Benjamin-C/ExploSnake/Breadboard_prototype/Breadboard_prototype_2.jpg

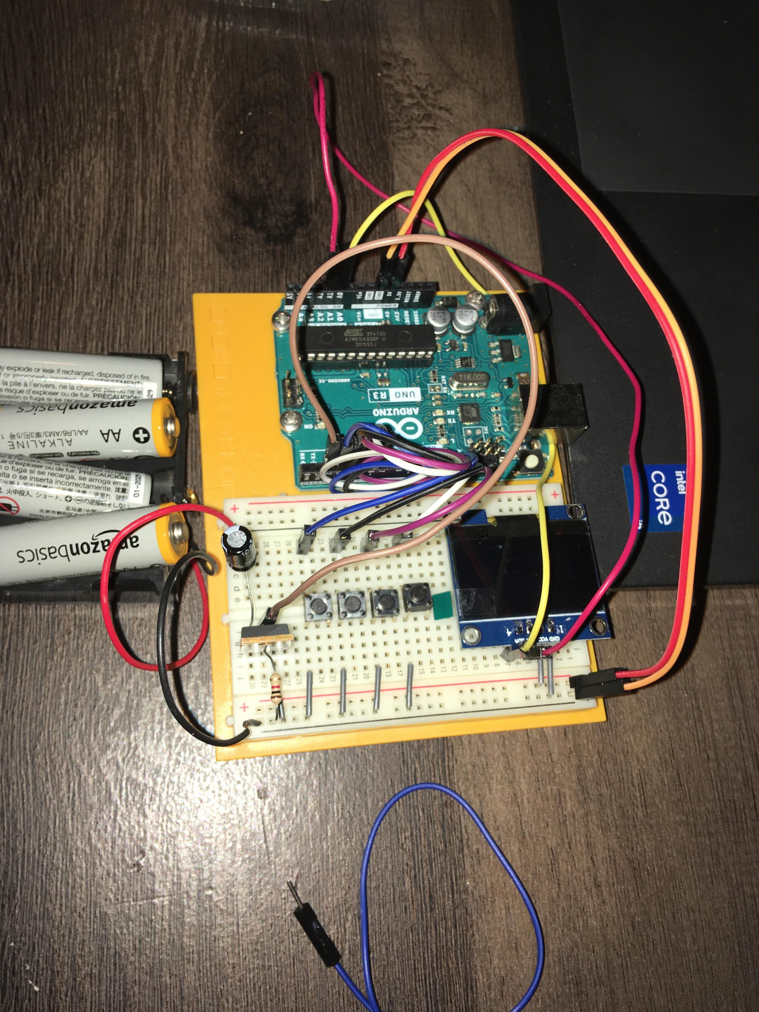
Breadboard_prototype/Breadboard_prototype_2.jpg
