Benjamin-C/ExploSnake/Breadboard_prototype/Breadboard_prototype_1.jpg

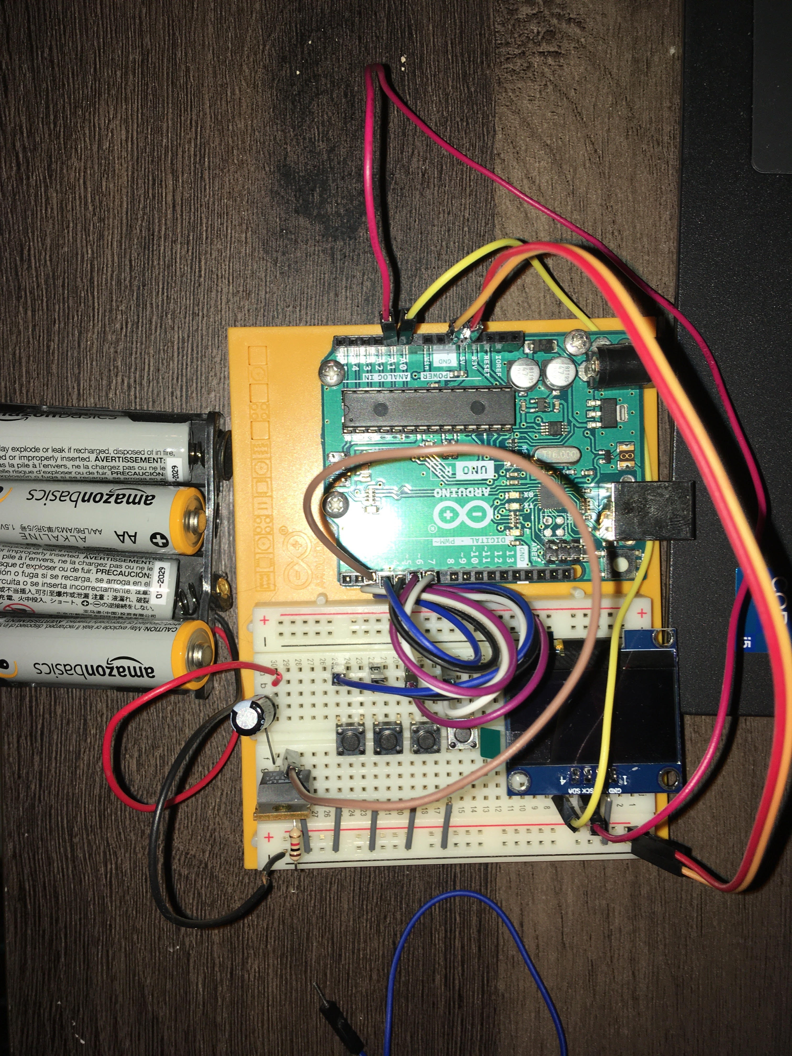
Breadboard_prototype/Breadboard_prototype_1.jpg
