Benjamin-C/ExploSnake/README.md

# ExploSnake
ExploSnake: Handheld Gaming with a Bang!
