Benjamin-C/ExploSnake/Team 2 Function Decomp 411.pdf

# ExploSnake Module

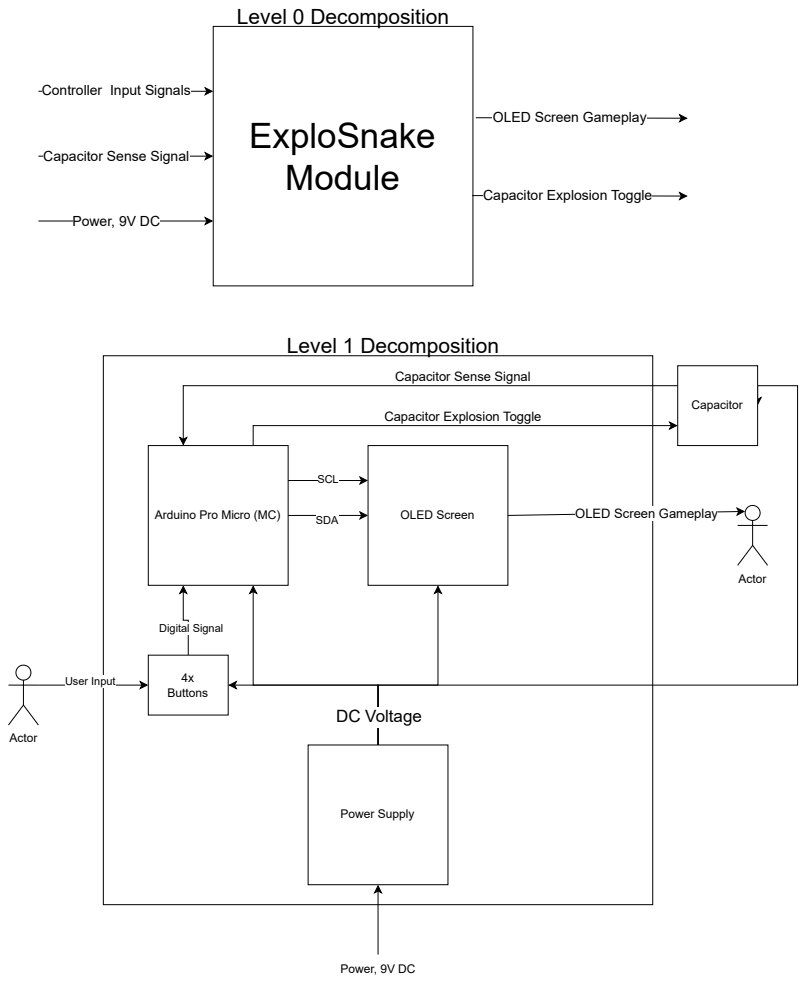
[picture p4: page 1]
Power, 9V DC; Level 0 Decomposition; SDA; Arduino Pro Micro (MC); OLED Screen; SCL; Power Supply; Level 1 Decomposition; Capacitor; Digital Signal; 4x Buttons; DC Voltage; Actor; User Input

Controller Input Signals

OLED Screen Gameplay

Capacitor Sense Signal

Capacitor Explosion Toggle
