Benjamin-C/ExploSnake/es-board/es-board.pdf

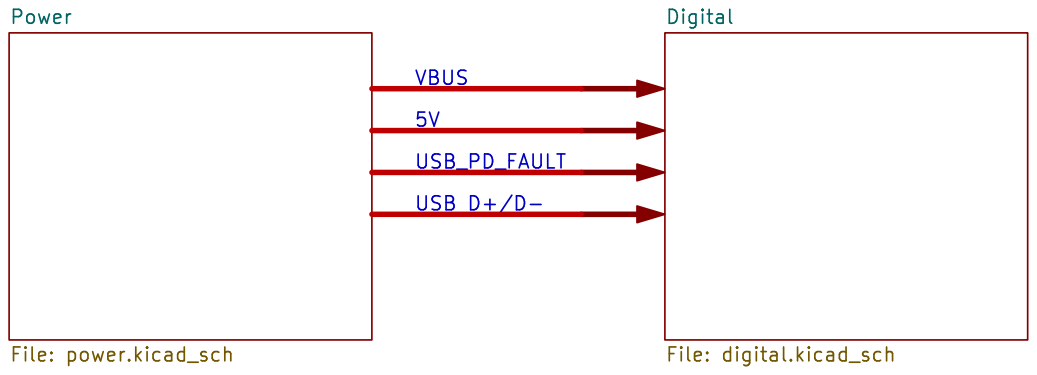
[picture p5: page 1]

Digital File: digital.kicad_sch VBUS

File: es-board.kicad_sch Sheet: / Team 2

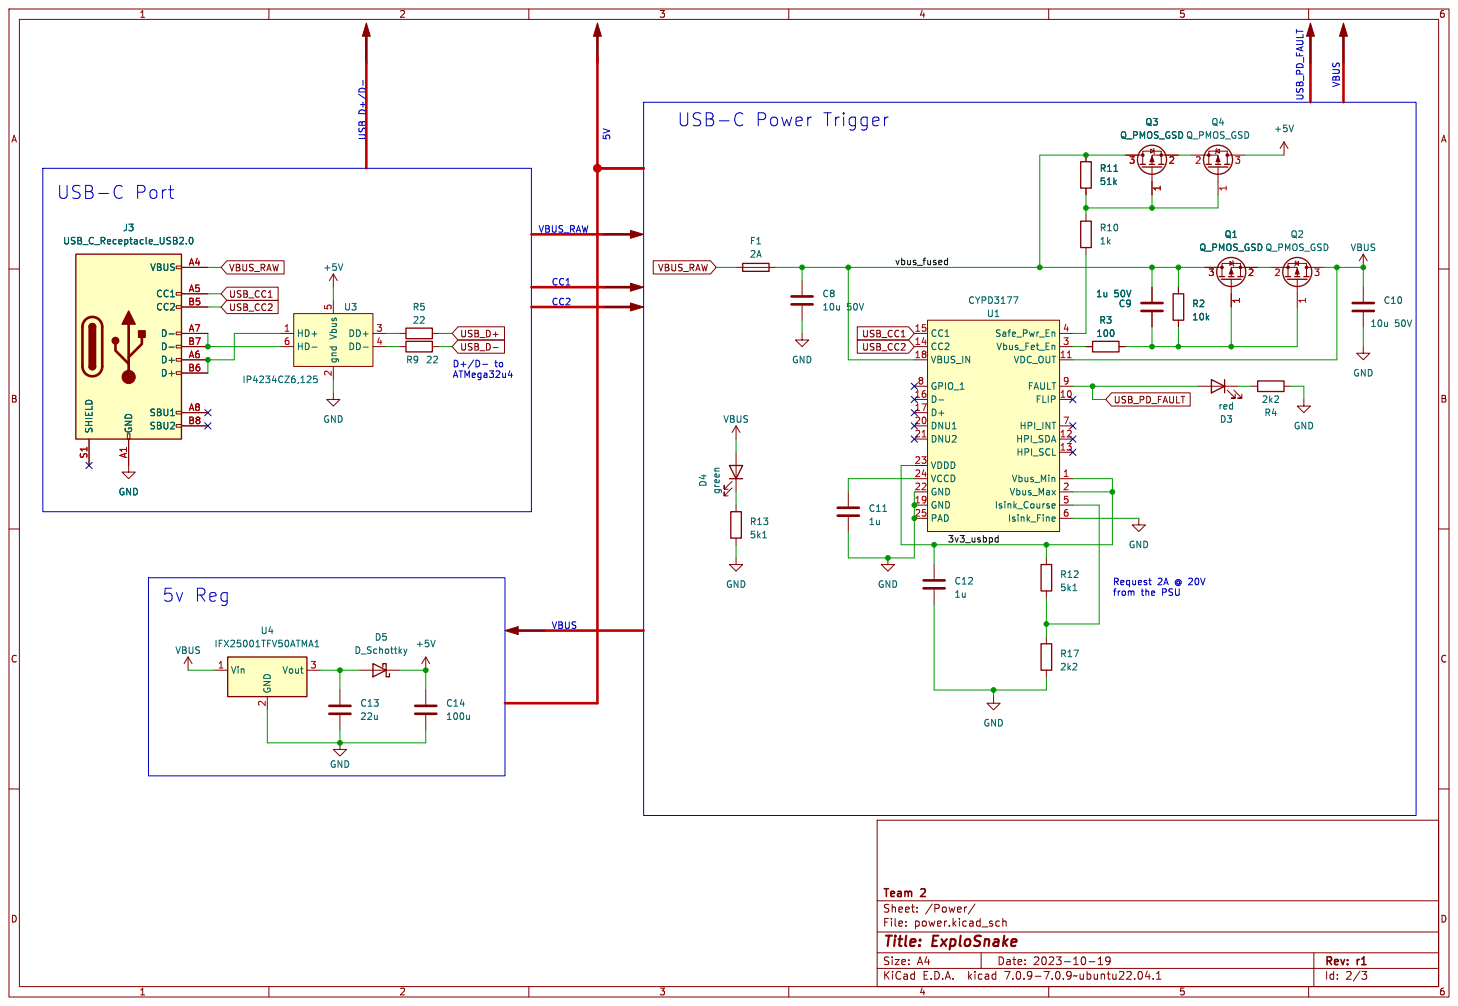
[picture p6: page 2]

from the PSU USB D+/D-

2 DD+ 3 DD- 4 Vbus 5 HD- 6 U3

File: power.kicad_sch Sheet: /Power/ Team 2 R13

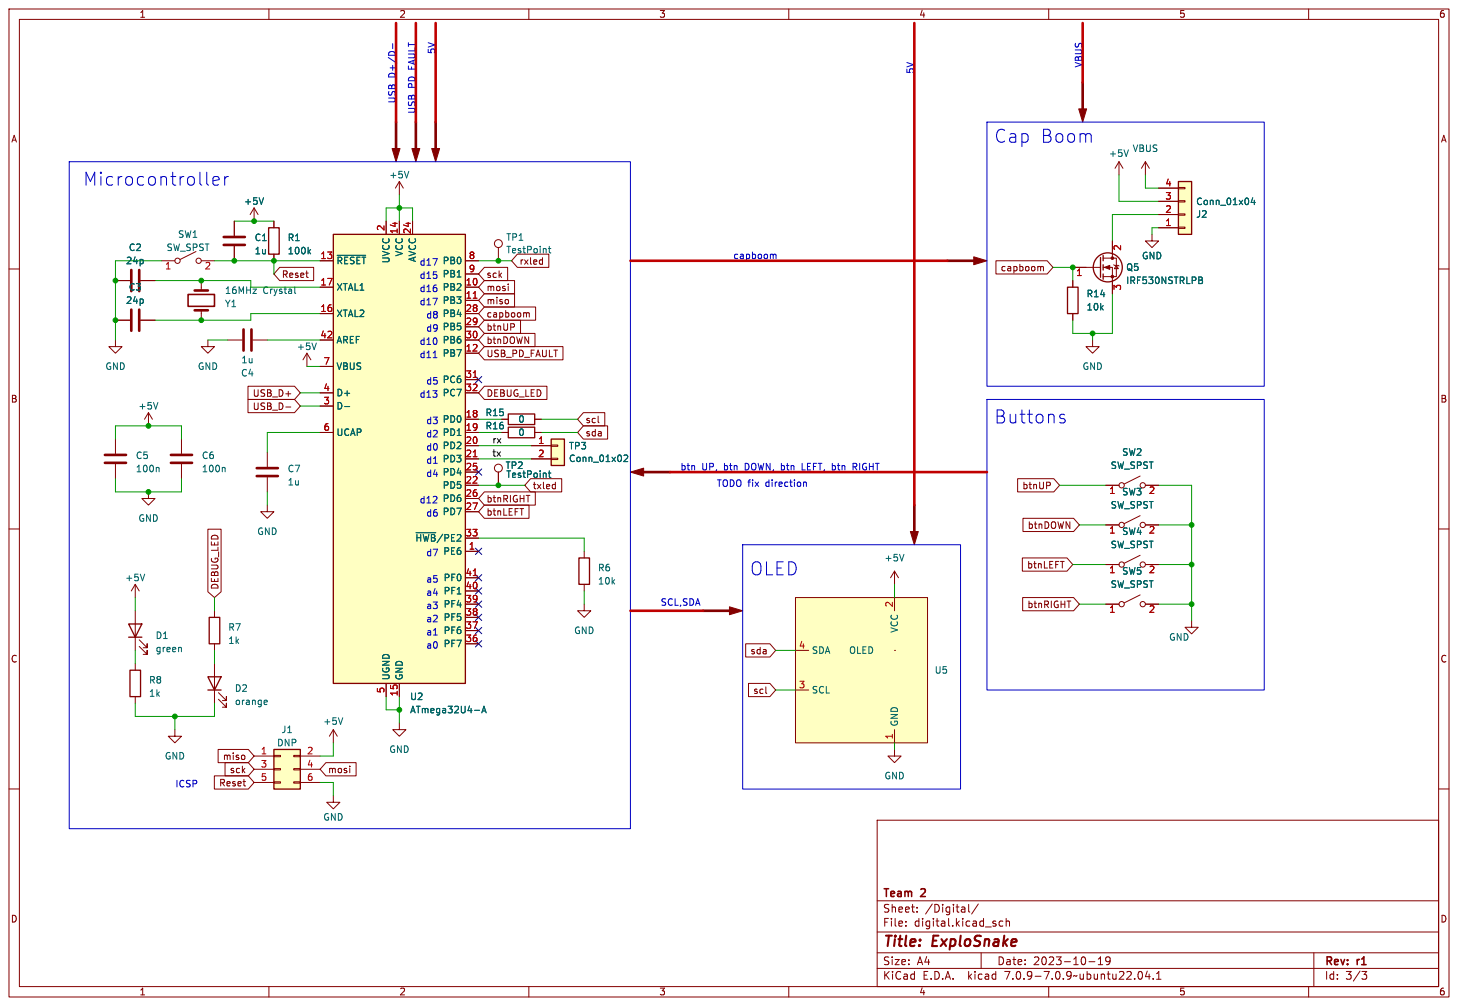
[picture p7: page 3]

btn UP, btn DOWN, btn LEFT, btn RIGHT

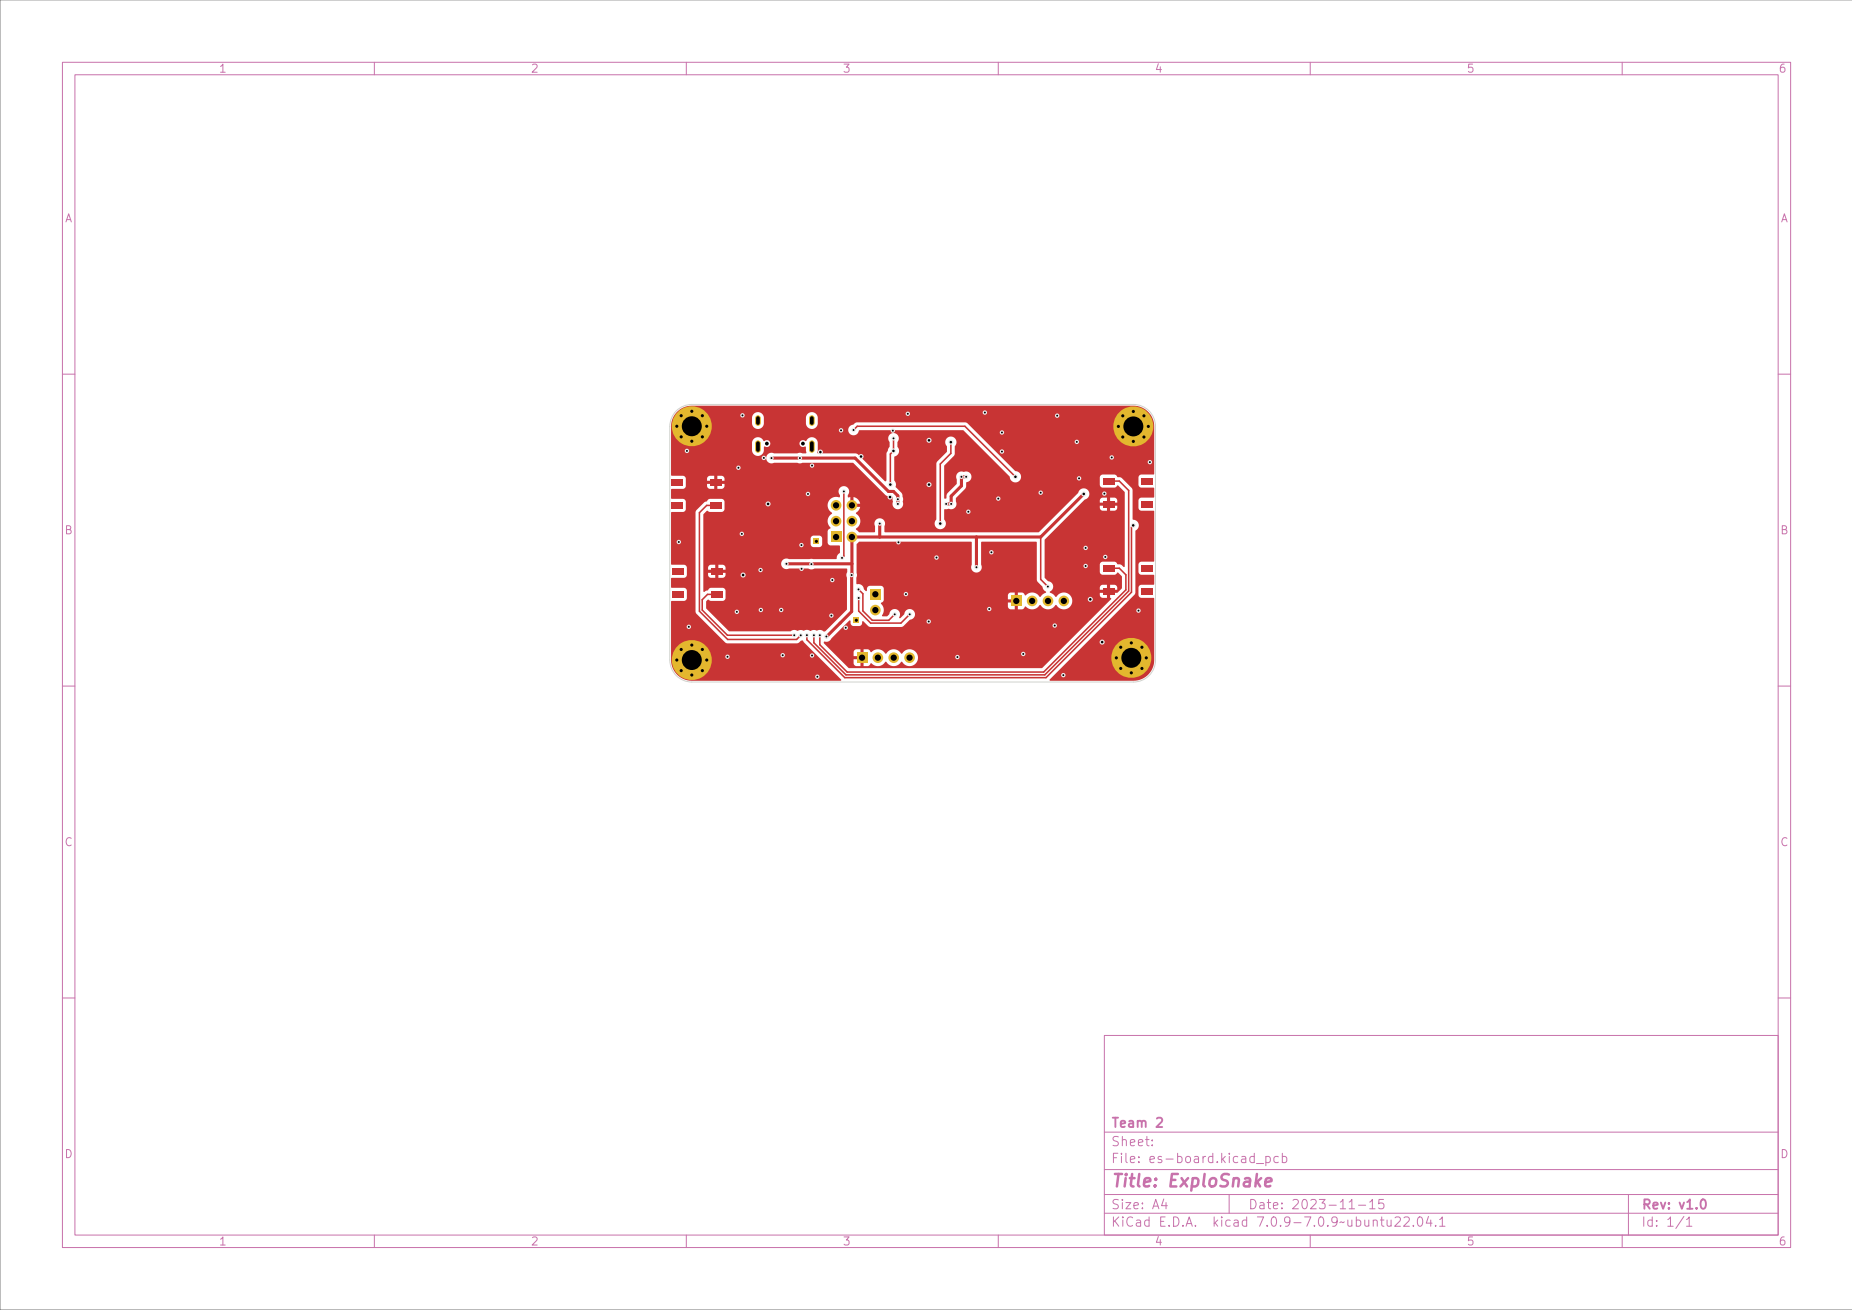
[picture p8: page 4]

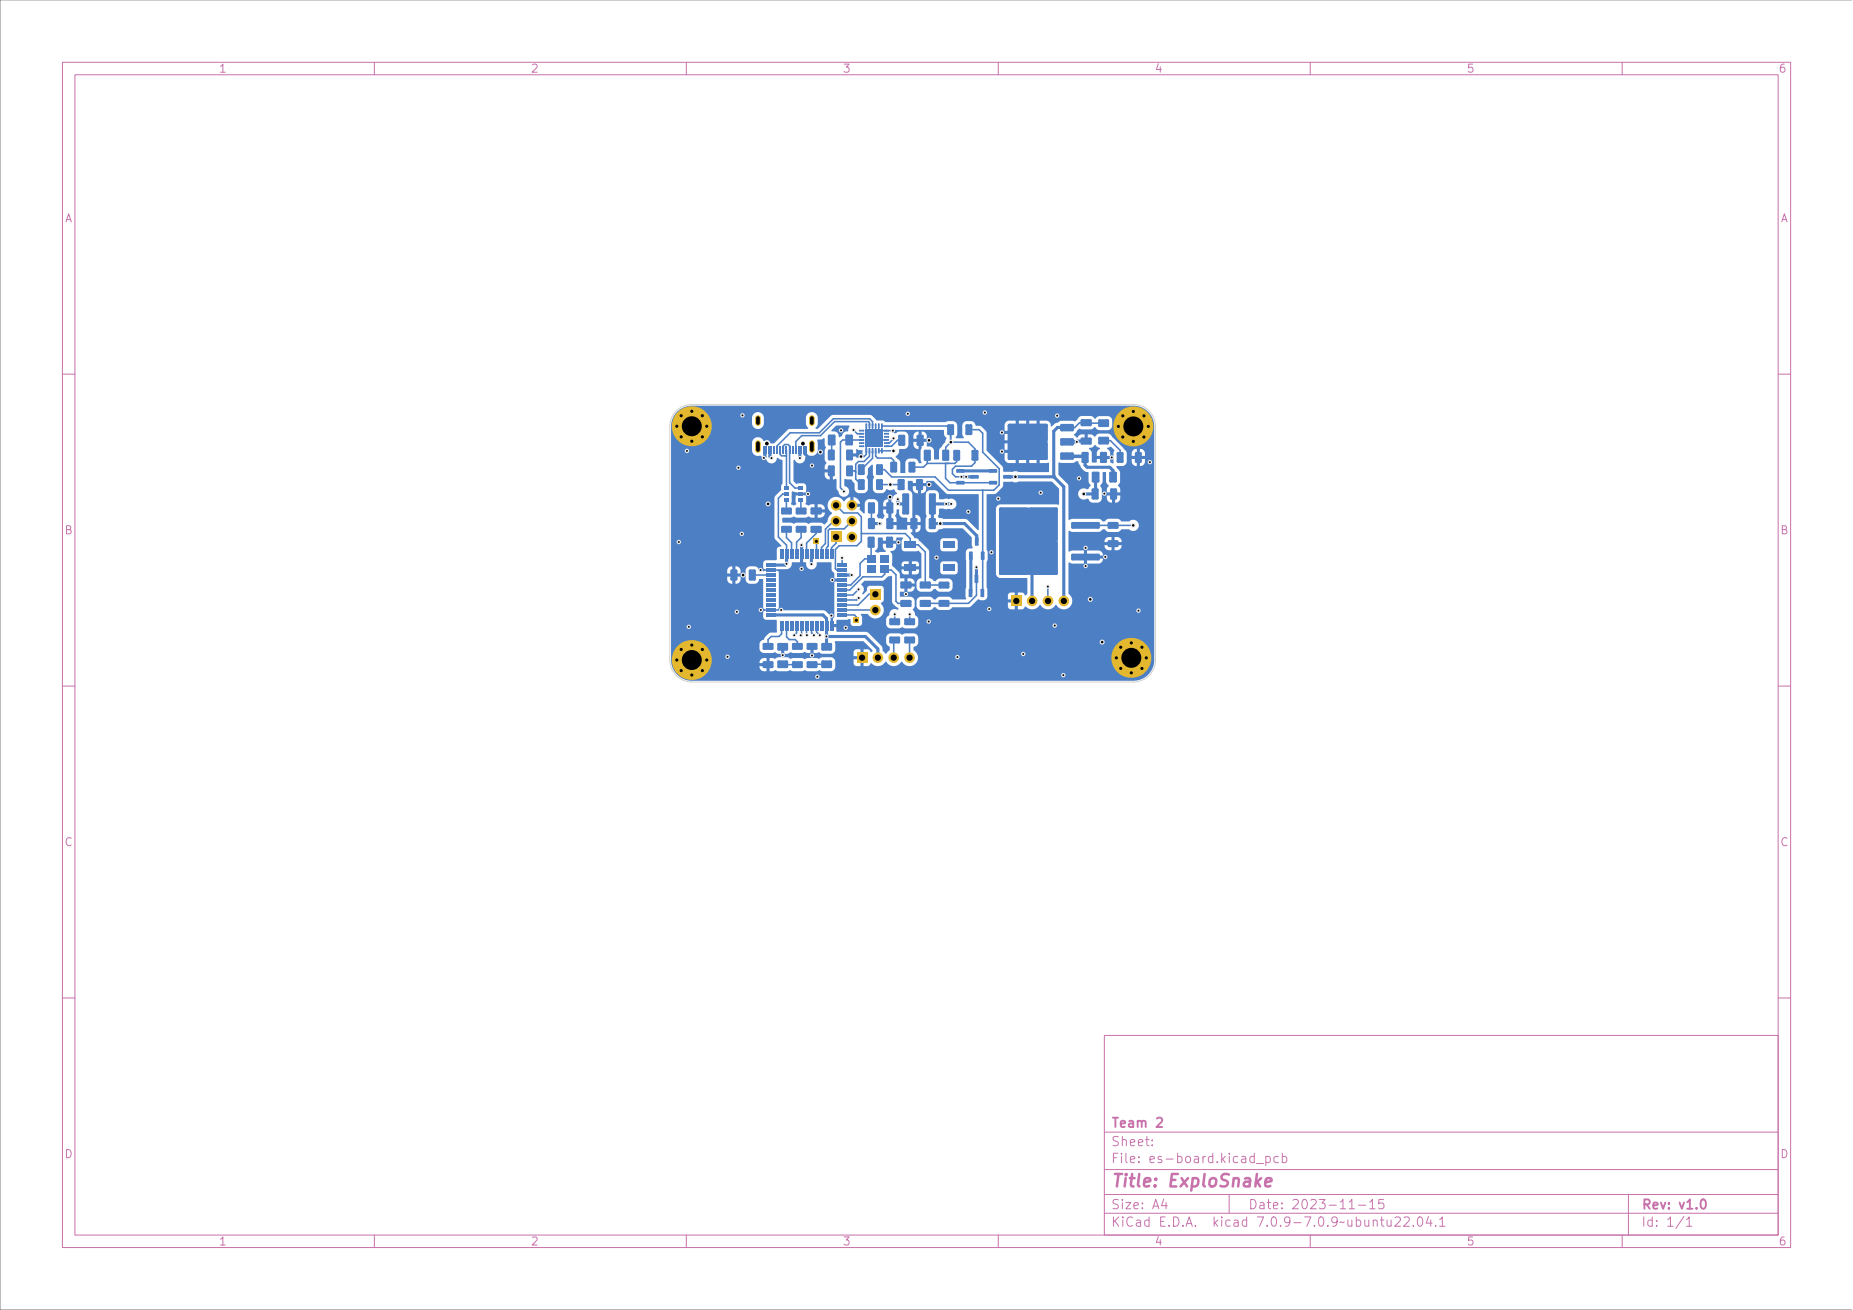
[picture p9: page 5]

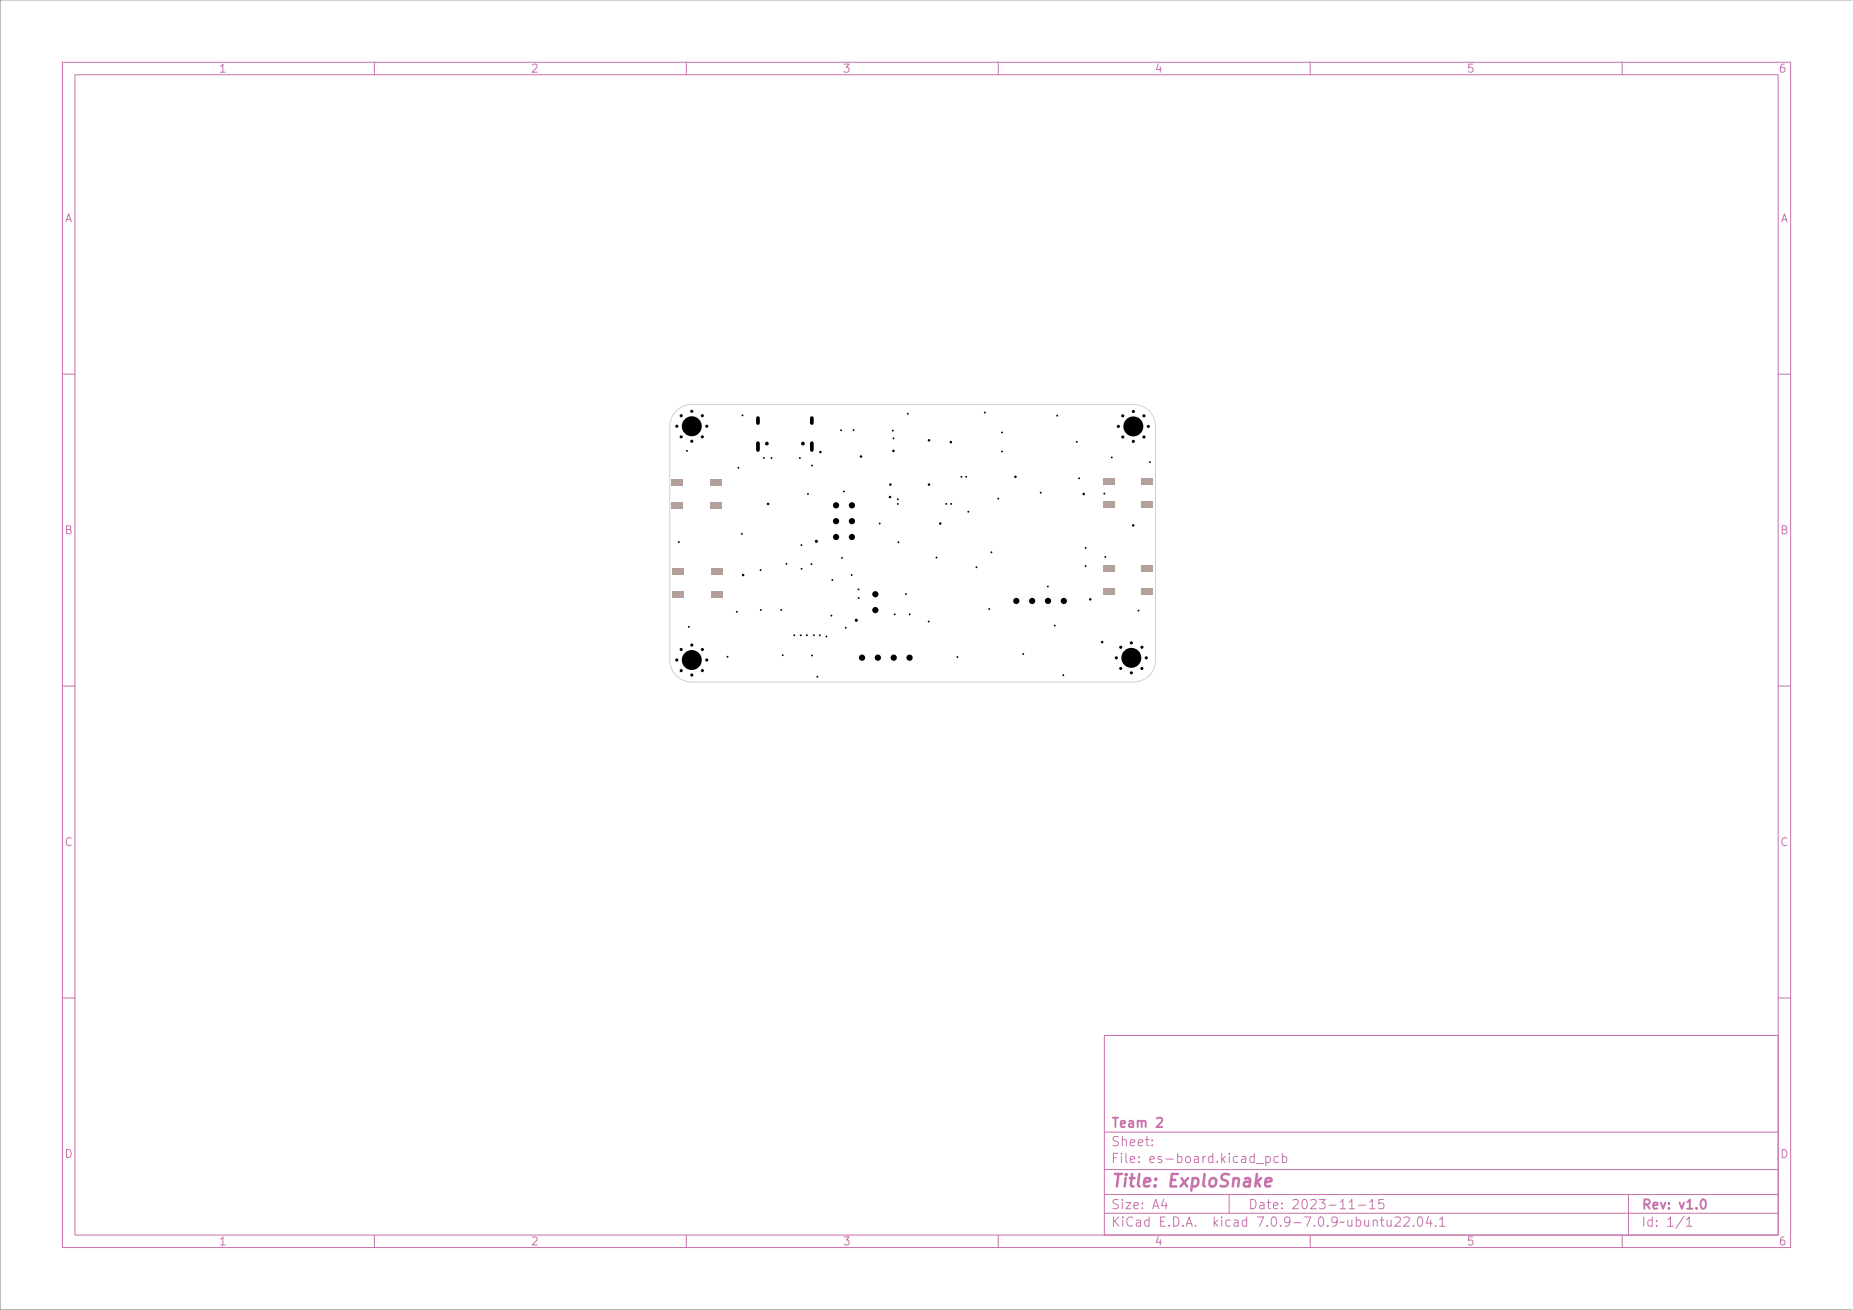
[picture p10: page 6]

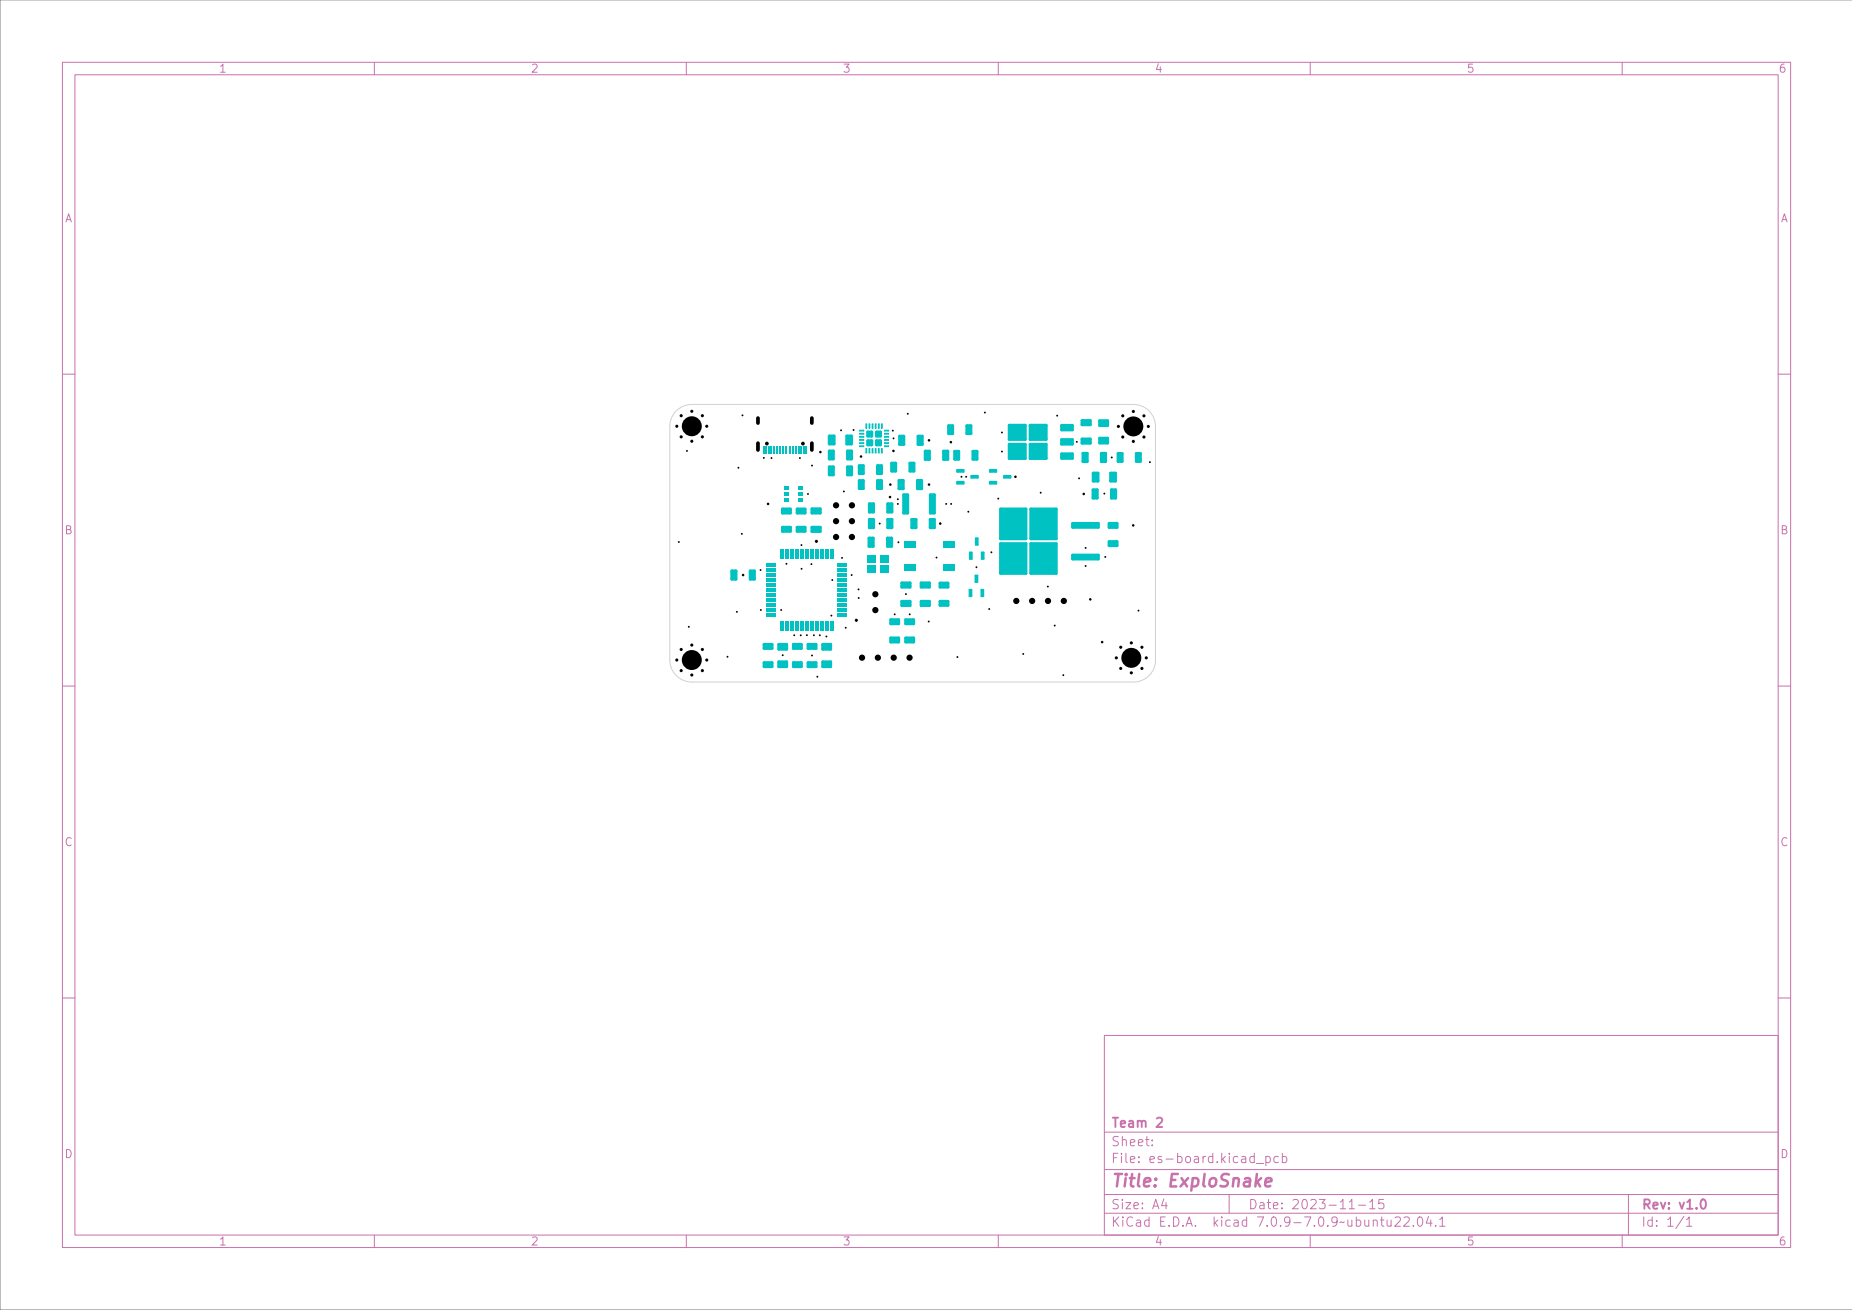
[picture p11: page 7]

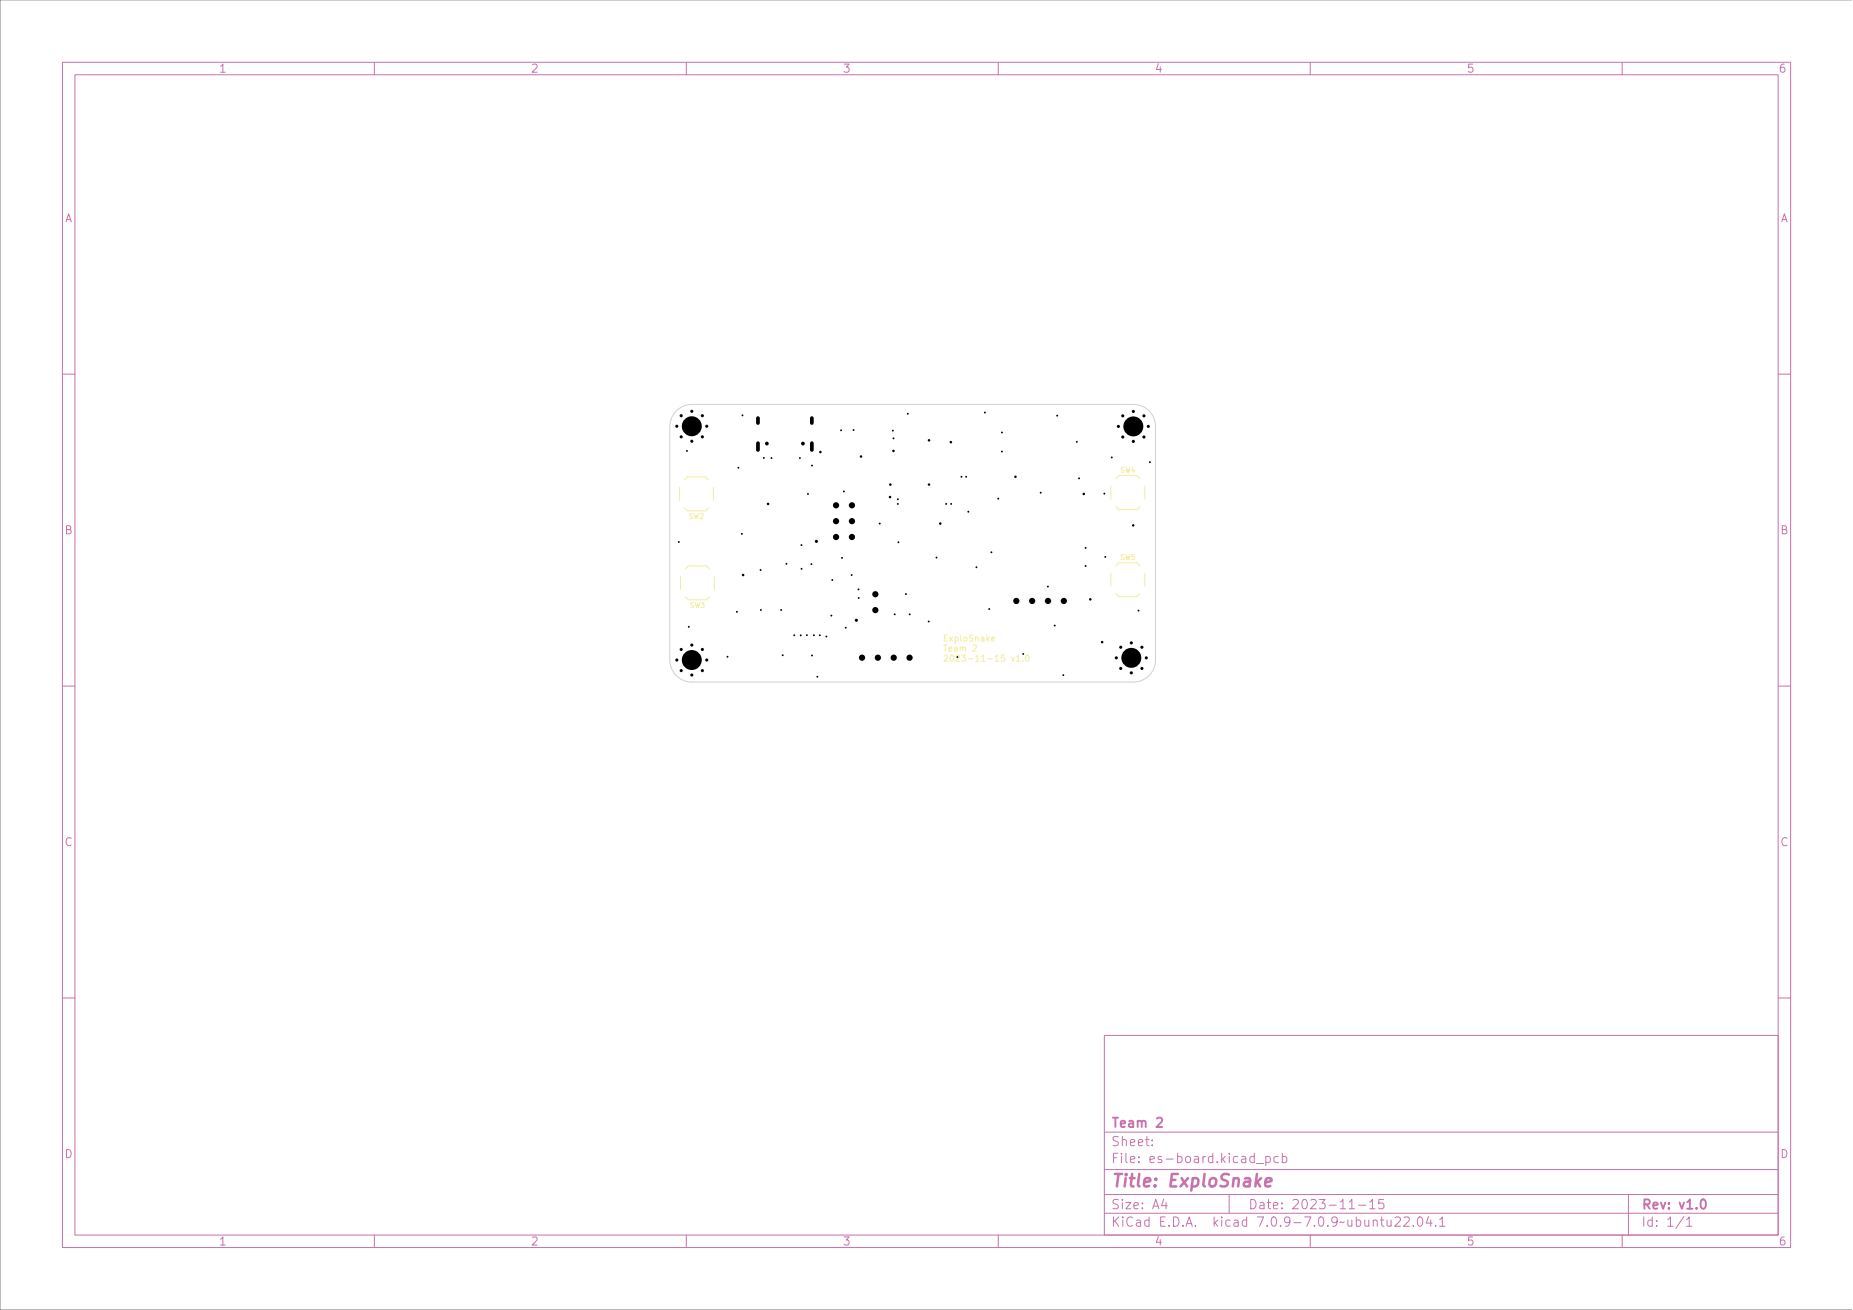
[picture p12: page 8]

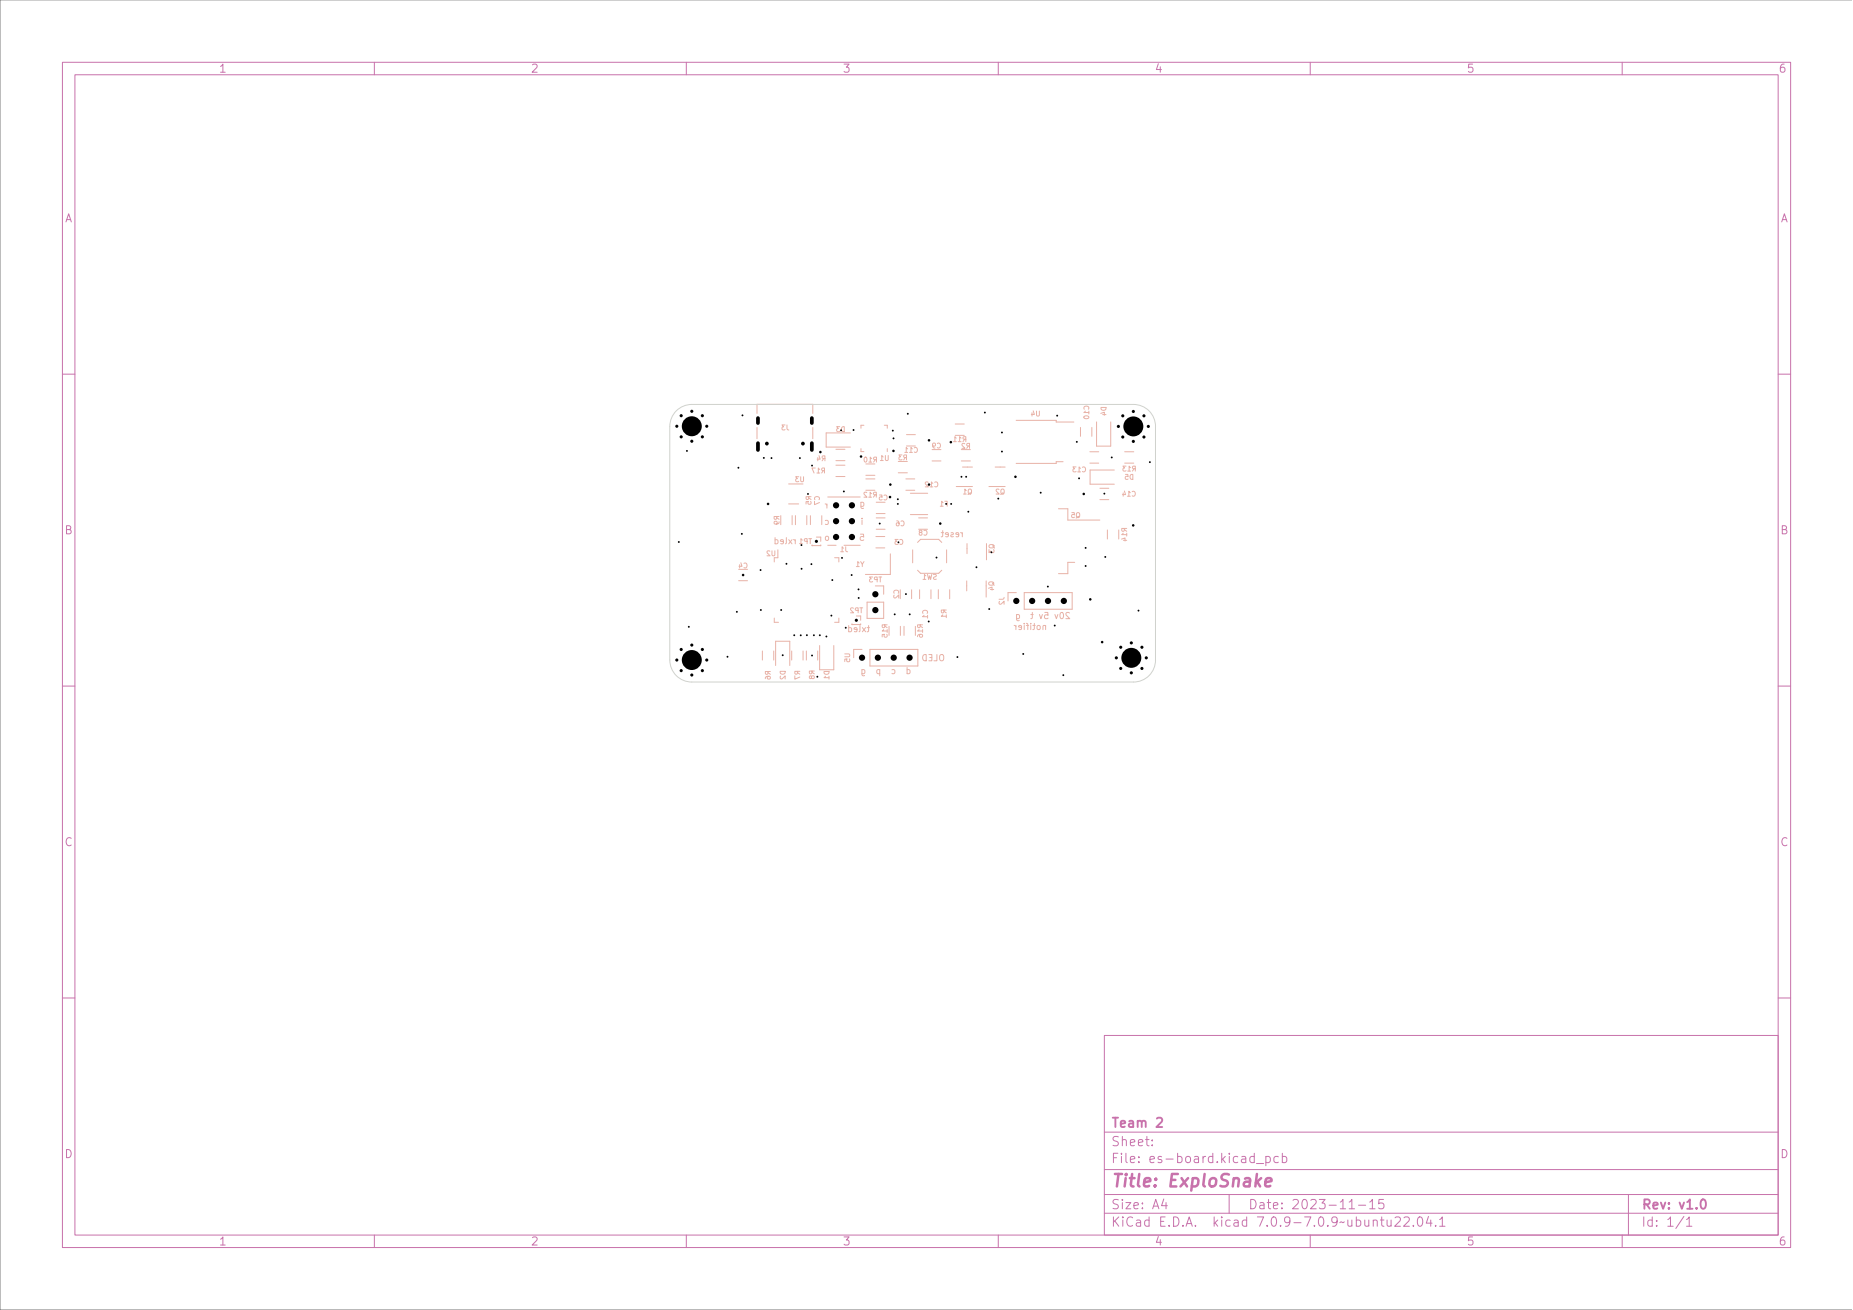
[picture p13: page 9]

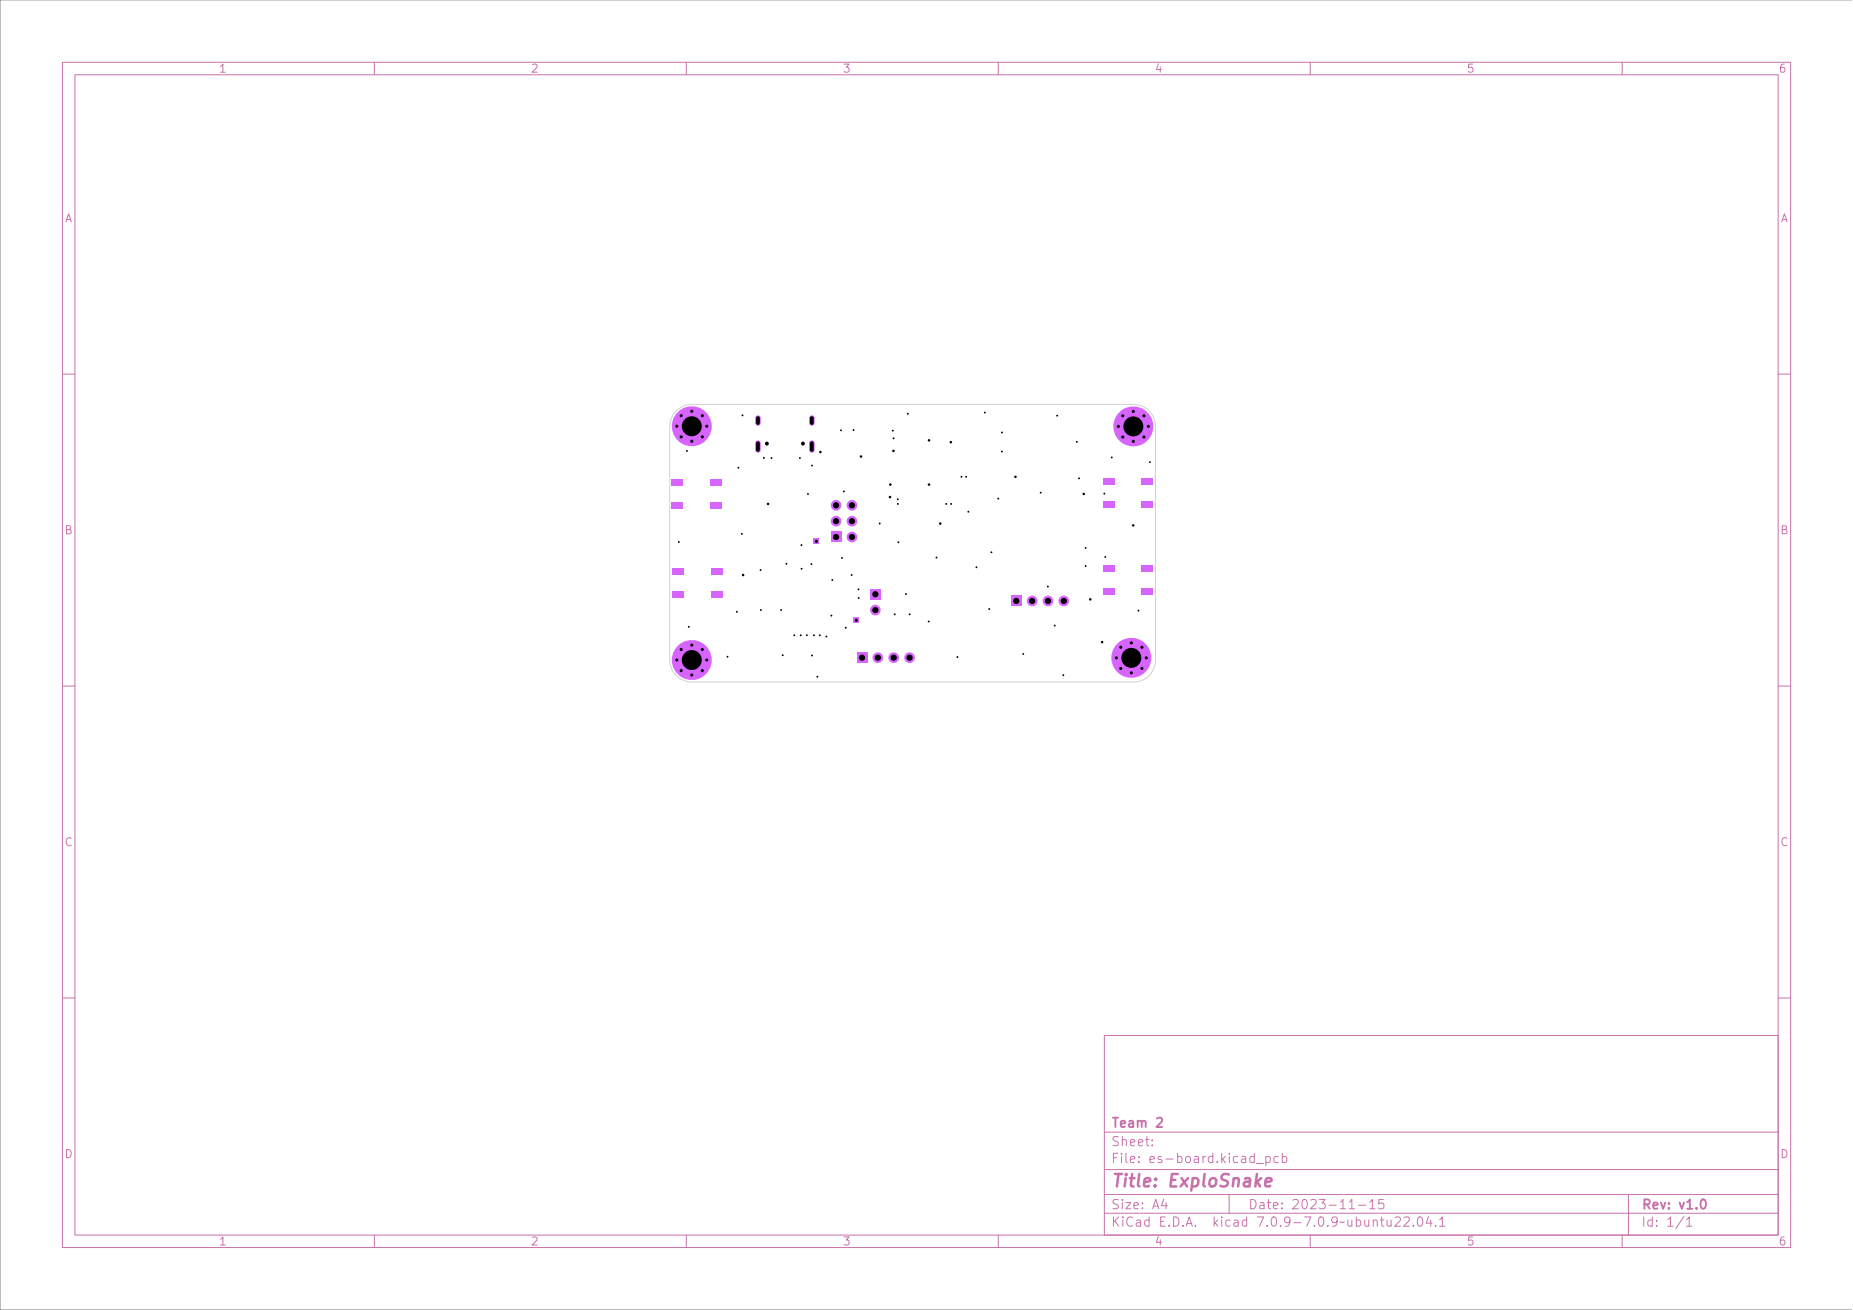
[picture p14: page 10]

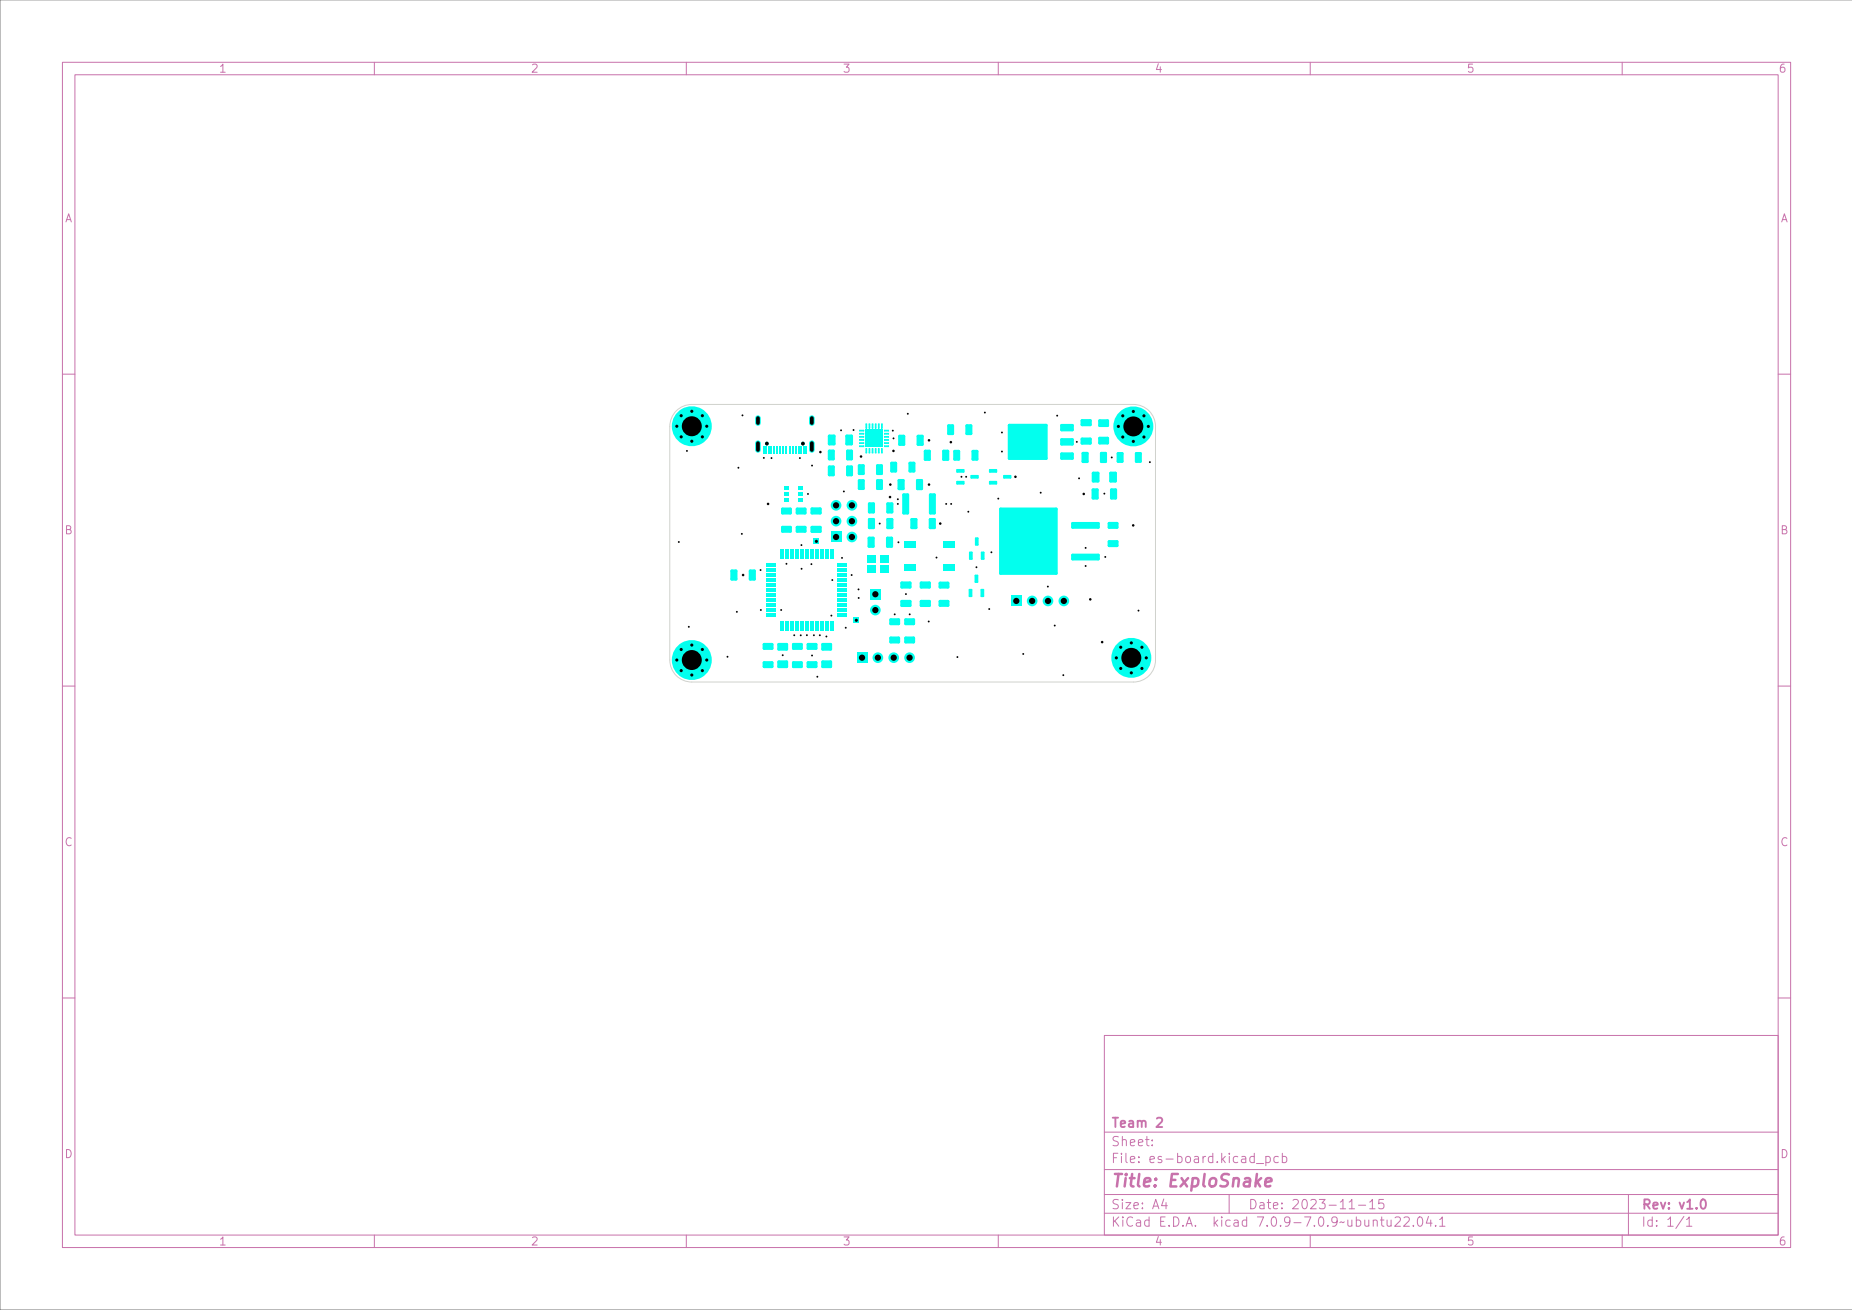
[picture p15: page 11]

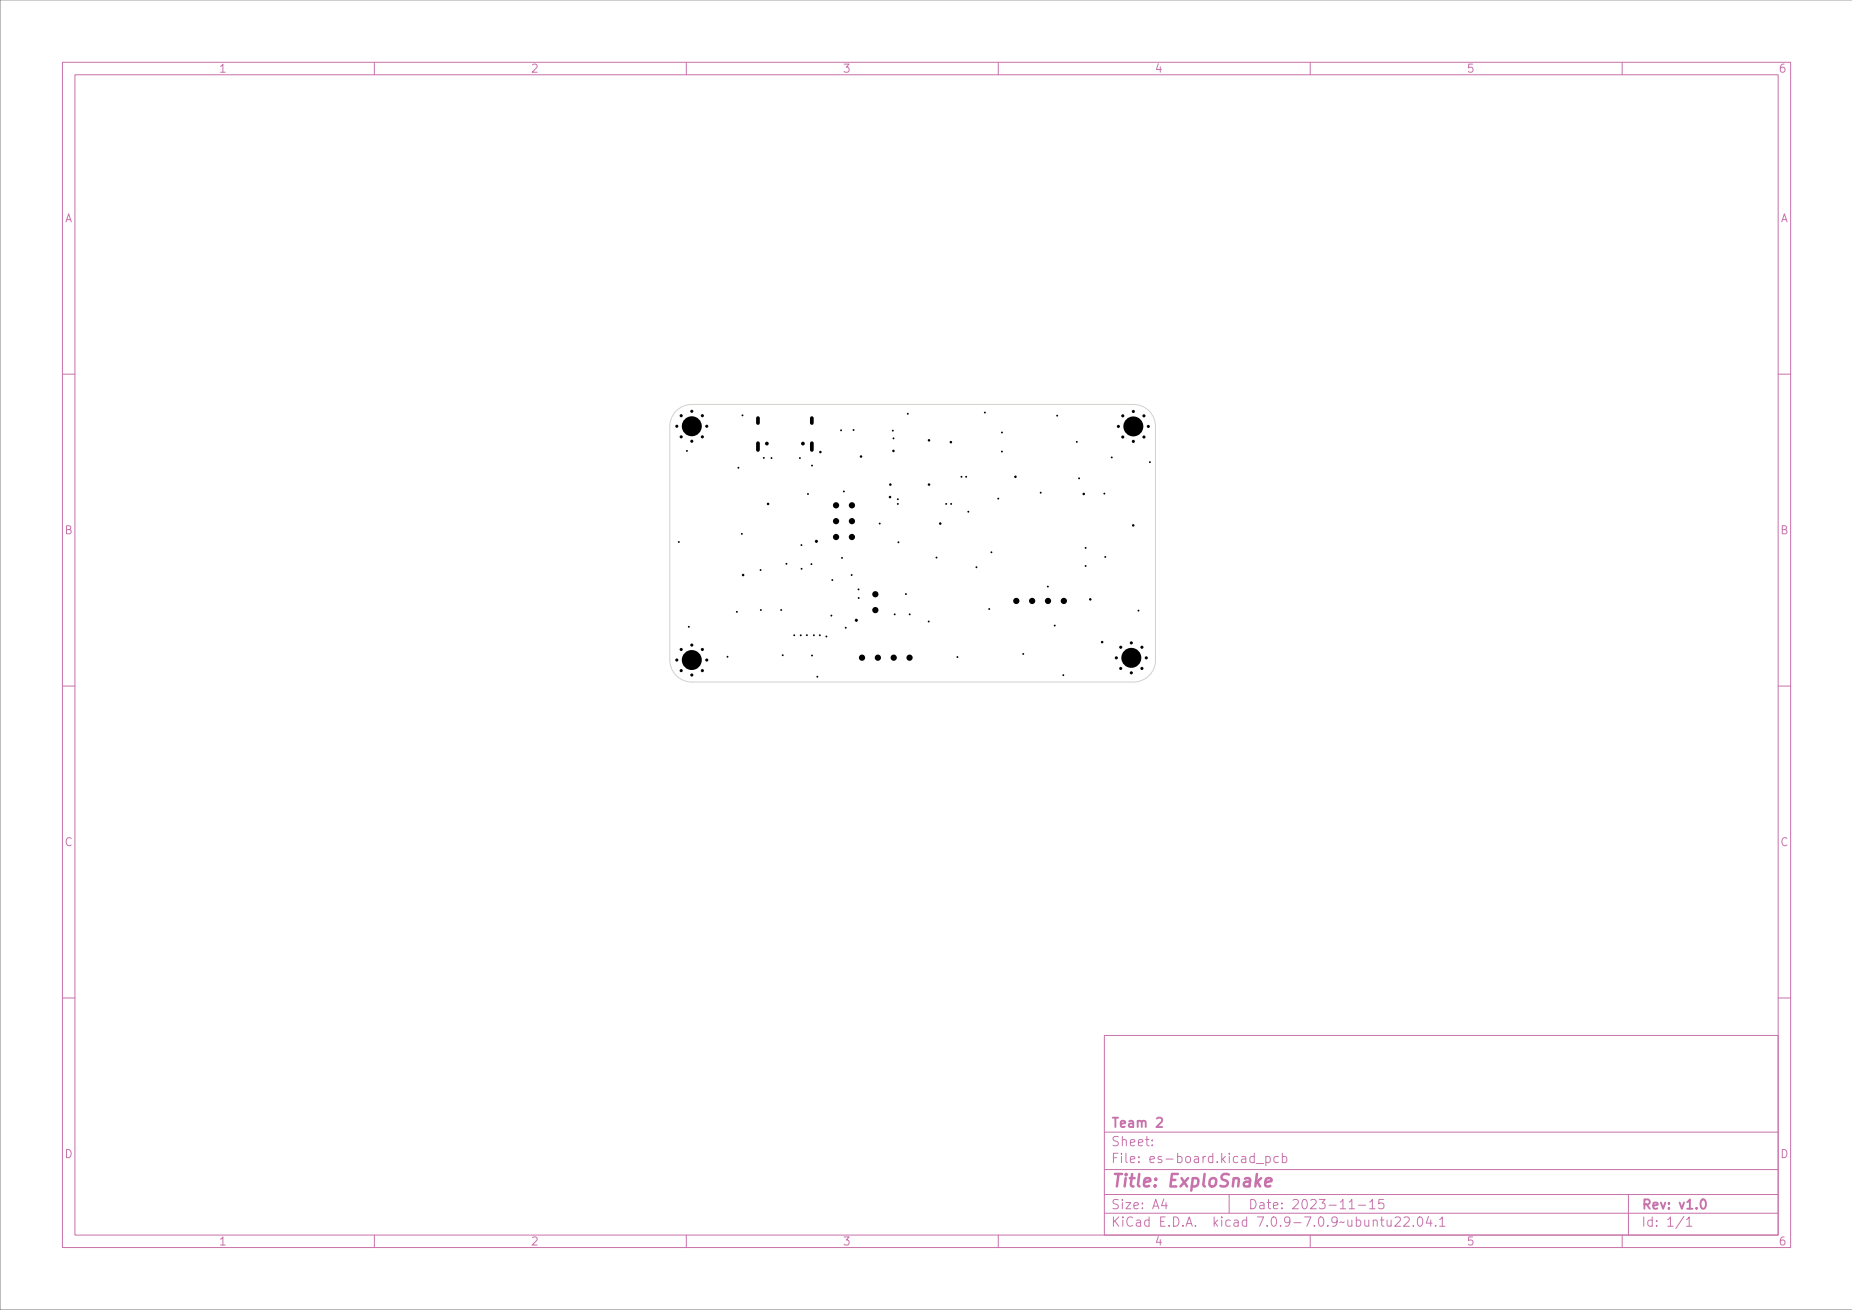
[picture p16: page 12]
