Benjamin-C/ExploSnake/Schedule/Team_2_project_schedule.pdf

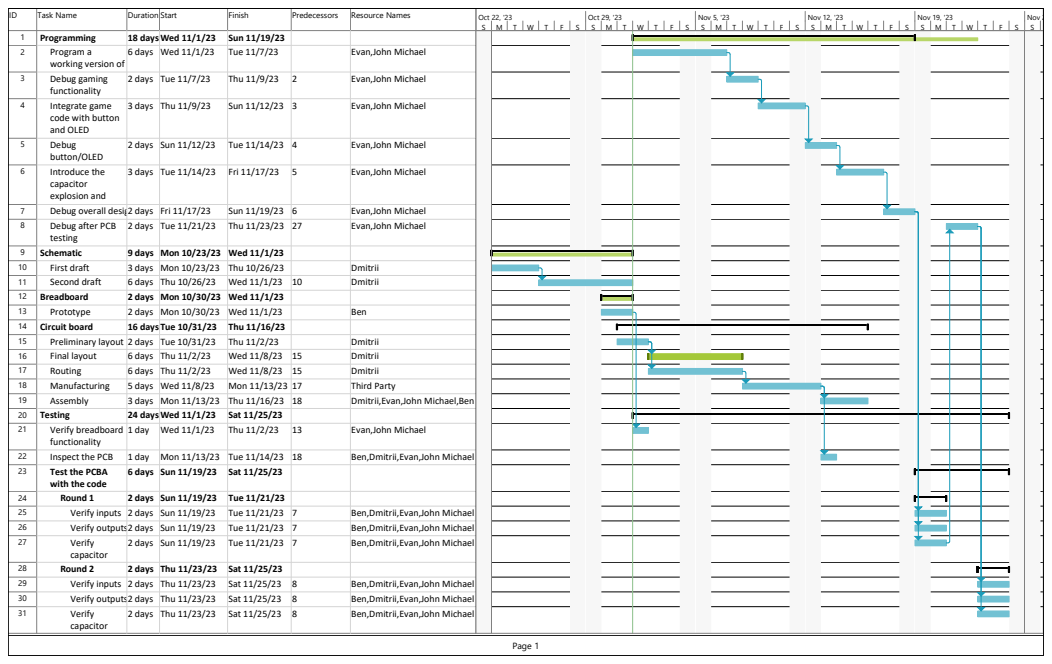
[picture p17: page 1]
Oct 22, '23; Oct 29, '23; Nov 5, '23; Nov 12, '23; Nov 19, '23; Nov 26, '23; Page 1

ID | Task Name | Duration Start | | Finish | Predecessors | Resource Names
1 | Programming | 18 days?Wed 11/1/23 | | Sun 11/19/23
2 Program a | working version of | 6 days | Wed 11/1/23 | Tue 11/7/23 | | Evan,John Michael

3 Debug gaming | functionality | 2 days | Tue 11/7/23 | Thu 11/9/23 | 2 | Evan,John Michael

4 Integrate game | code with button and OLED | 3 days | Thu 11/9/23 | Sun 11/12/23 | 3 | Evan,John Michael

5 Debug | button/OLED | 2 days | Sun 11/12/23 | Tue 11/14/23 | 4 | Evan,John Michael

6 Introduce the | capacitor explosion and | 3 days | Tue 11/14/23 | Fri 11/17/23 | 5 | Evan,John Michael

7 | Debug overall design2 days | | Fri 11/17/23 | Sun 11/19/23 | 6 | Evan,John Michael
8 Debug after PCB | testing | 2 days | Tue 11/21/23 | Thu 11/23/23 | 27 | Evan,John Michael

9 | Schematic | 9 days | Mon 10/23/23 | Wed 11/1/23
10 | First draft | 3 days | Mon 10/23/23 | Thu 10/26/23 | | Dmitrii
11 | Second draft | 6 days | Thu 10/26/23 | Wed 11/1/23 | 10 | Dmitrii
12 | Breadboard | 2 days | Mon 10/30/23 | Wed 11/1/23
13 | Prototype | 2 days | Mon 10/30/23 | Wed 11/1/23 | | Ben
14 | Circuit board | 16 days Tue 10/31/23 | | Thu 11/16/23
15 | Preliminary layout | 2 days | Tue 10/31/23 | Thu 11/2/23 | | Dmitrii
16 | Final layout | 6 days | Thu 11/2/23 | Wed 11/8/23 | 15 | Dmitrii
17 | Routing | 6 days | Thu 11/2/23 | Wed 11/8/23 | 15 | Dmitrii
18 | Manufacturing | 5 days | Wed 11/8/23 | Mon 11/13/23 | 17 | Third Party
19 | Assembly | 3 days | Mon 11/13/23 | Thu 11/16/23 | 18 | Dmitrii,Evan,John Michael,Ben
20 | Testing | 24 daysWed 11/1/23 | | Sat 11/25/23
21 Verify breadboard | functionality | 1 day | Wed 11/1/23 | Thu 11/2/23 | 13 | Evan,John Michael

22 | Inspect the PCB | 1 day | Mon 11/13/23 | Tue 11/14/23 | 18 | Ben,Dmitrii,Evan,John Michael
23 Test the PCBA | with the code | 6 days | Sun 11/19/23 | Sat 11/25/23

24 | Round 1 | 2 days | Sun 11/19/23 | Tue 11/21/23
25 | Verify inputs | 2 days | Sun 11/19/23 | Tue 11/21/23 | 7 | Ben,Dmitrii,Evan,John Michael
26 | Verify outputs2 days | | Sun 11/19/23 | Tue 11/21/23 | 7 | Ben,Dmitrii,Evan,John Michael
27 Verify | capacitor | 2 days | Sun 11/19/23 | Tue 11/21/23 | 7 | Ben,Dmitrii,Evan,John Michael

28 | Round 2 | 2 days | Thu 11/23/23 | Sat 11/25/23
29 | Verify inputs | 2 days | Thu 11/23/23 | Sat 11/25/23 | 8 | Ben,Dmitrii,Evan,John Michael
30 | Verify outputs2 days | | Thu 11/23/23 | Sat 11/25/23 | 8 | Ben,Dmitrii,Evan,John Michael
31 Verify | capacitor | 2 days | Thu 11/23/23 | Sat 11/25/23 | 8 | Ben,Dmitrii,Evan,John Michael
