Benjamin-C/ExploSnake/es-board/es-board.kicad_pcb

## KiCad design es-board/es-board.kicad_pcb (2023-12-07)

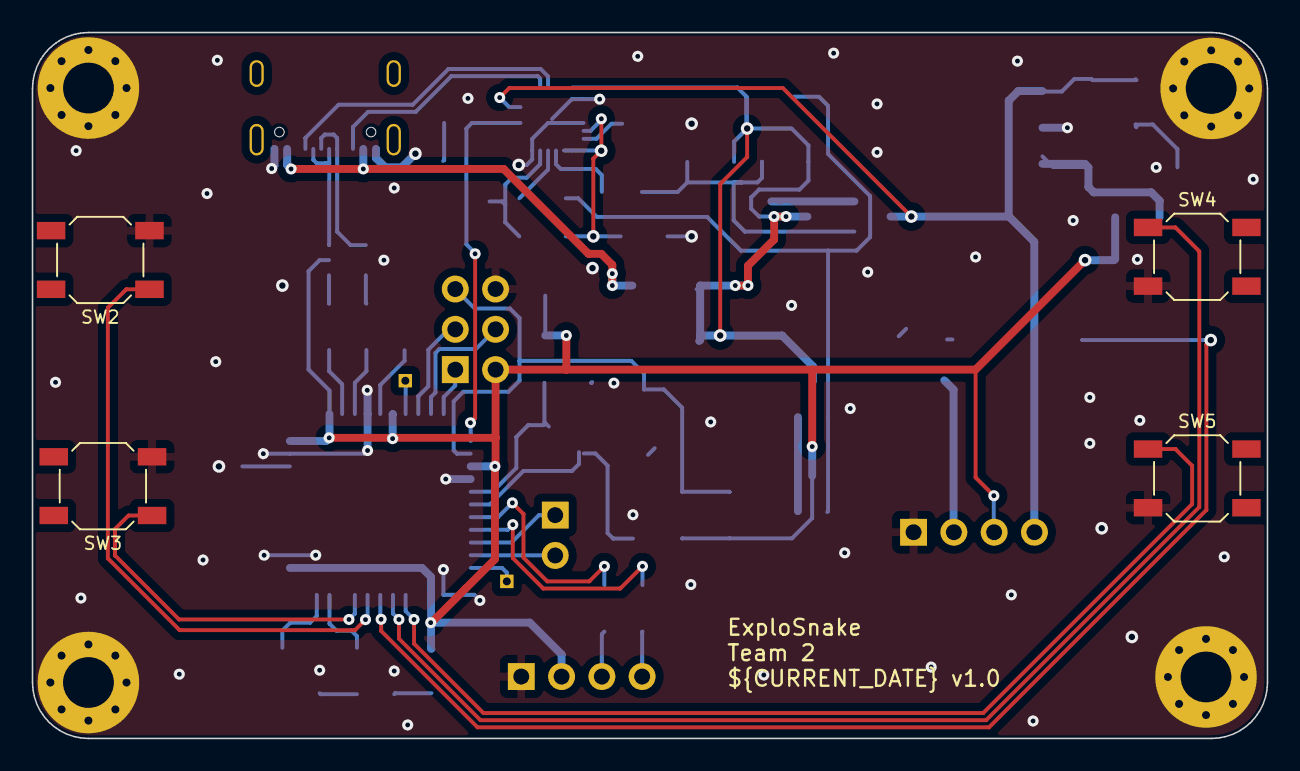
[picture p18: board es-board.kicad_pcb from above]

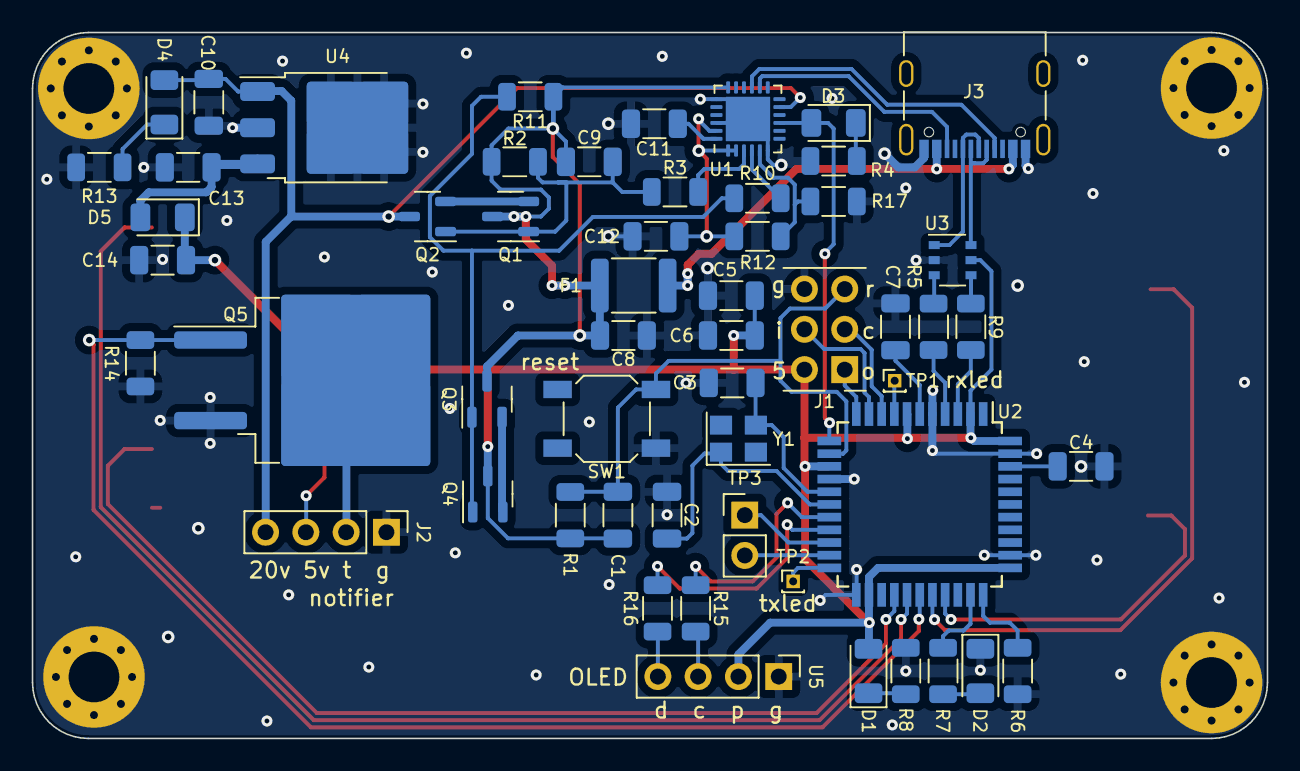
[picture p19: board es-board.kicad_pcb from below]

Board: 2 copper layers, 77.9 x 44.5 mm, 59 parts (55 on the bottom side), 52 nets.

Parts:
C1, C4, C7, C11, C12: 1u; C_1206_3216Metric
C2, C3: 24p; C_1206_3216Metric
C5, C6: 100n; C_1206_3216Metric
C8, C10: 10u 50V; C_1206_3216Metric
C9: 1u 50V; C_1206_3216Metric
C13: 22u; C_1206_3216Metric
C14: 100u; C_1206_3216Metric
D1, D4: green; LED_1206_3216Metric
D2: orange; LED_1206_3216Metric
D3: red; LED_1206_3216Metric
D5: D_Schottky; D_1206_3216Metric
F1: 2A; Fuse_1812_4532Metric
J1: DNP; PinHeader_2x03_P2.54mm_Vertical
J2: DNP; PinHeader_1x04_P2.54mm_Vertical
J3: USB_C_Receptacle_USB2.0; USB_C_Receptacle_Palconn_UTC16-G
Q1, Q2, Q3, Q4: Q_PMOS_GSD; SOT-23-3
Q5: IRF530NSTRLPB; TO-263-2_TabPin2
R1: 100k; R_1206_3216Metric
R2, R6, R14: 10k; R_1206_3216Metric
R3: 100; R_1206_3216Metric
R4, R17: 2k2; R_1206_3216Metric
R5, R9: 22; R_1206_3216Metric
R7, R8, R10: 1k; R_1206_3216Metric
R11: 51k; R_1206_3216Metric
R12, R13: 5k1; R_1206_3216Metric
R15, R16: 0; R_1206_3216Metric
SW1, SW2, SW3, SW4, SW5: SW_SPST; SW_SPST_SKQG_WithStem
TP1, TP2: DNP; PinHeader_1x01_P1.00mm_Vertical
TP3: DNP; PinHeader_1x02_P2.54mm_Vertical
U1: CYPD3177; QFN-24-1EP_4x4mm_P0.5mm_EP2.8x2.8mm
U2: ATmega32U4-A; TQFP-44_10x10mm_P0.8mm
U3: IP4234CZ6,125; TSOP-6_1.65x3.05mm_P0.95mm
U4: IFX25001TFV50ATMA1; TO-252-3_TabPin2
U5: OLED; PinHeader_1x04_P2.54mm_Vertical
Y1: 16MHz Crystal; Crystal_SMD_3225-4Pin_3.2x2.5mm

Connections:
+5V: C1.1, C5.1, C6.1, C14.1, D1.2 (A), D5.1 (K), J1.2, J2.3, Q4.3 (D), R1.1, U2.2 (UVCC), U2.7 (VBUS), U2.14 (VCC), U2.24 (AVCC), U2.34 (VCC), U2.44 (AVCC), U3.5 (Vbus), U5.2 (VCC)
/Digital/rx: TP3.1, U2.20 (PD2)
/Digital/tx: TP3.2, U2.21 (PD3)
/Power/3v3_usbpd: C12.1, R12.1, U1.1 (Vbus_Min), U1.2 (Vbus_Max), U1.23 (VDDD)
/Power/vbus_fused: C8.1, C9.1, F1.2, Q1.3 (D), Q3.3 (D), R2.1, R11.1, U1.18 (VBUS_IN)
DEBUG_LED: R7.1, U2.32 (PC7)
GND: C2.2, C3.2, C4.2, C5.2, C6.2, C7.2, C8.2, C10.2, C11.2, C12.2, C13.1, C14.2, D2.1 (K), J1.6, J2.1, J3.A1 (GND), J3.A12 (GND), J3.B1 (GND), J3.B12 (GND), Q5.3 (S), R4.2, R6.2, R8.2, R13.2, R14.1, R17.2, SW1.1 (A), SW2.2 (B), SW3.2 (B), SW4.2 (B), SW5.2 (B), U1.6 (Isink_Fine), U1.19 (GND), U1.22 (GND), U1.25 (PAD), U2.5 (UGND), U2.15 (GND), U2.23 (GND), U2.35 (GND), U2.43 (GND), U3.2 (gnd), U4.2 (GND), U5.1 (GND)
unnamed: D1.1 (K), R8.1
unnamed: D2.2 (A), R7.2
unnamed: D3.1 (K), R4.1
unnamed: D4.1 (K), R13.1
unnamed: C13.2, D5.2 (A), U4.3 (Vout)
unnamed: J2.2, Q5.2 (D)
unnamed: C9.2, Q1.1 (G), Q2.1 (G), R2.2, R3.2
unnamed: Q1.2 (S), Q2.2 (S)
unnamed: Q3.1 (G), Q4.1 (G), R10.1, R11.2
unnamed: Q3.2 (S), Q4.2 (S)
unnamed: R12.2, R17.1, U1.5 (Isink_Course)
unnamed: R10.2, U1.4 (Safe_Pwr_En)
unnamed: C11.1, U1.24 (VCCD)
unnamed: R3.1, U1.3 (Vbus_Fet_En)
unnamed: C4.1, U2.42 (AREF)
unnamed: R15.1, U2.18 (PD0)
unnamed: R16.1, U2.19 (PD1)
unnamed: C7.1, U2.6 (UCAP)
unnamed: C2.1, U2.17 (XTAL1), Y1.1
unnamed: C3.1, U2.16 (XTAL2), Y1.2
unnamed: R6.1, U2.33 (~HWB/PE2)
unnamed: R5.1, U3.3 (DD+)
unnamed: R9.2, U3.4 (DD-)
unnamed: J3.A6 (D+), J3.B6 (D+), U3.1 (HD+)
unnamed: J3.A7 (D-), J3.B7 (D-), U3.6 (HD-)
Reset: C1.2, J1.5, R1.2, SW1.2 (B), U2.13 (~RESET)
USB_CC1: J3.A5 (CC1), U1.15 (CC1)
USB_CC2: J3.B5 (CC2), U1.14 (CC2)
USB_D+: R5.2, U2.4 (D+)
USB_D-: R9.1, U2.3 (D-)
USB_PD_FAULT: D3.2 (A), U1.9 (FAULT), U2.12 (PB7)
VBUS: C10.1, D4.2 (A), J2.4, Q2.3 (D), U1.11 (VDC_OUT), U4.1 (Vin)
VBUS_RAW: F1.1, J3.A4 (VBUS), J3.A9 (VBUS), J3.B4 (VBUS), J3.B9 (VBUS)
btnDOWN: SW3.1 (A), U2.30 (PB6)
btnLEFT: SW4.1 (A), U2.27 (PD7)
btnRIGHT: SW5.1 (A), U2.26 (PD6)
btnUP: SW2.1 (A), U2.29 (PB5)
capboom: Q5.1 (G), R14.2, U2.28 (PB4)
miso: J1.1, U2.11 (PB3)
mosi: J1.4, U2.10 (PB2)
rxled: TP1.1, U2.8 (PB0)
sck: J1.3, U2.9 (PB1)
scl: R15.2, U5.3 (SCL)
sda: R16.2, U5.4 (SDA)
txled: TP2.1, U2.22 (PD5)
