Benjamin-C/ExploSnake/(commit log)

2023-10-19 Created schematic
    [digital.kicad_sch, es-board.kicad_pcb, es-board.kicad_sch, power.kicad_sch]
2023-10-24 Added capacitor circuit
    [digital.kicad_sch]
2023-10-24 Added OLED symbol
    [digital.kicad_sch]
2023-10-25 Added buttons and OLED
    [digital.kicad_sch]
2023-10-25 Slight cleanups
    [digital.kicad_sch]
2023-10-26 Added net labels for buttons
    [digital.kicad_sch]
2023-11-02 Updated footprints
    [digital.kicad_sch, power.kicad_sch]
2023-11-02 Preliminary layout completed
    [digital.kicad_sch, es-board.kicad_pcb]
2023-11-02 Exported schematic and layout to PDF
2023-11-02 Exported layout to PDF
    [es-board.kicad_pcb]
2023-11-02 Created pdfs of schematic and board layout
    [es-board.kicad_pcb]
2023-11-02 Added pics of breadboard prototype
2023-11-04 Picked boom MOSFET
    [digital.kicad_sch]
2023-11-07 Did some routing
    [es-board.kicad_pcb]
2023-11-09 Added BOM
    [digital.kicad_sch, es-board.csv, es-board.kicad_pcb, power.kicad_sch]
2023-11-09 Updated BOM format
    [es-board.csv]
2023-11-09 cleaned up BOM
    [es-board-bom.csv]
2023-11-09 Updated board layout
    [es-board.kicad_pcb]
2023-11-09 Individual Test Files for components
    explosnake_outline.ino is just an outline for the game.
    oled_I2C.ino is a display test for the oled display.
    push_buttons.ino is just for testing the buttons.
2023-11-15 Finished electricaling
    [digital.kicad_sch, es-board.kicad_pcb, power.kicad_sch]
2023-11-15 Fixed board outline and silkscreen
    [digital.kicad_sch, es-board.kicad_pcb]
2023-11-16 Design review tweaks
    [digital.kicad_sch, es-board.kicad_pcb]
2023-11-16 Prep for fab
    [es-board.kicad_pcb]
2023-11-16 Added PDF of schematic and board
2023-11-16 updated BOM
    [digital.kicad_sch, es-board-bom.csv, es-board-bom.xls, es-board.csv, es-board.kicad_sch, power.kicad_sch]
2023-11-16 Set up export settings for fab and updated BOM
    [es-board-bom.xls, es-board.kicad_pcb]
2023-12-07 Added test plan
    [es-board.kicad_pcb, power.kicad_sch]
2023-12-08 Updated Function Decomp
    Changed the votage input from 9V to 20V.
